manuito/robot-small/arduino/option/Servo.ino

int servoAngle = 0;   // servo position in degrees

void startServo(){
  servo.attach(SERVO_PIN);
}

void rotateServo(){
  
//if you change the delay value (from example change 50 to 10), the speed of the servo changes
  for(servoAngle = 0; servoAngle < 180; servoAngle++)  //move the micro servo from 0 degrees to 180 degrees
  {                                  
    servo.write(servoAngle);              
    delay(50);                  
  }

  for(servoAngle = 180; servoAngle > 0; servoAngle--)  //now move back the micro servo from 0 degrees to 180 degrees
  {                                
    servo.write(servoAngle);          
    delay(10);      
  }
  //end control the servo's speed  

}
